ahensana/water-level/RealDataFromSite/WhatsApp Image 2026-08-13 at 1.24.08 PM.jpeg

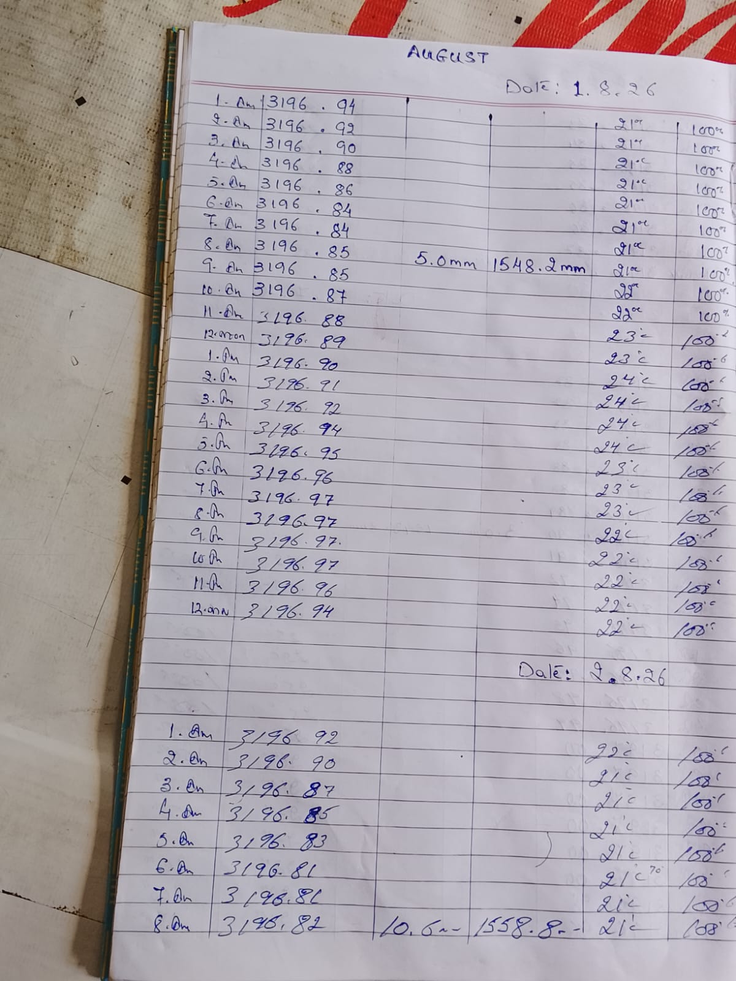
RealDataFromSite/WhatsApp Image 2026-08-13 at 1.24.08 PM.jpeg
