ahensana/water-level/RealDataFromSite/WhatsApp Image 2026-08-13 at 1.24.14 PM.jpeg

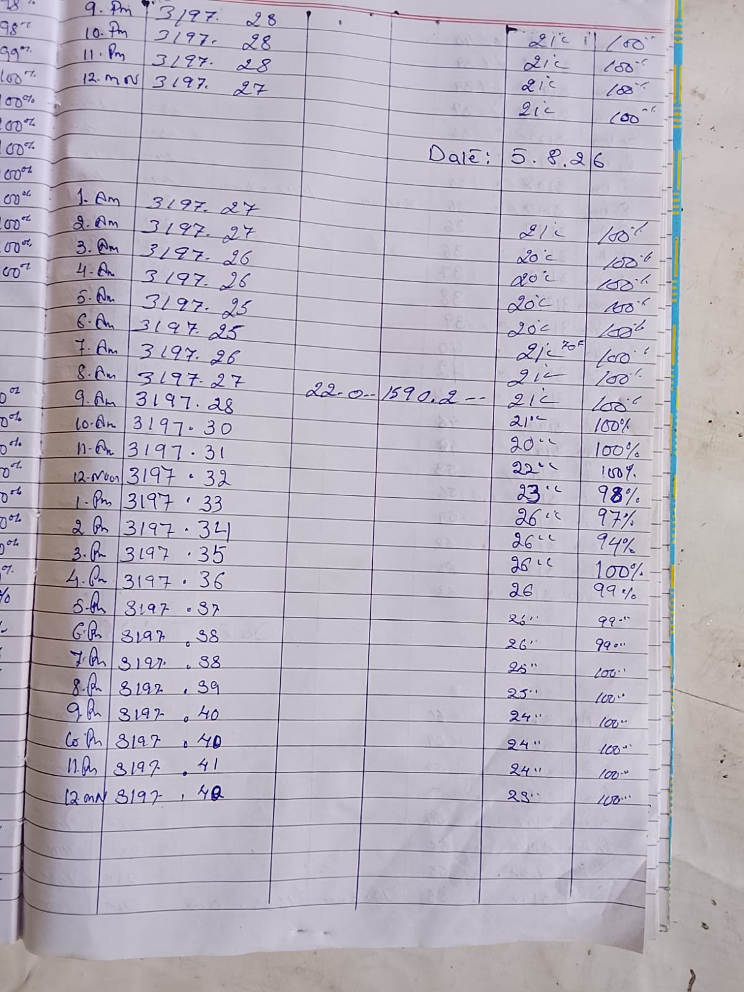
RealDataFromSite/WhatsApp Image 2026-08-13 at 1.24.14 PM.jpeg
