ahensana/water-level/(commit log)

2026-08-05 Add initial implementation for ESP32-S3 water level monitoring with EC200U modem
    - Introduced `esp32s3_ec200u_test.ino` for water level bring-up test, including modem and sensor setup, self-test procedures, and data upload to Firebase.
    - Created `.firebase/hosting.YXBwXGRpc3Q.cache` for hosting assets.
    - Added `package-lock.json` for project dependencies management.
2026-09-25 Show the last trusted reading instead of a loading shimmer
    Three related fixes to how the dashboard behaves once readings stop being
    trusted:
    - HeroStats/GaugeCard treated "too old to trust" the same as "still
    loading", so the cards went blank after an hour even though the last
    trusted reading was in hand. They now show it, badged Not current, with
    no zone colour so it cannot read as a live safe/critical state.
    - "Last Updated" showed the last TRUSTED reading, so a device uploading
    rejected readings looked like a device that had gone silent. It now
    shows the last reading received, with the trusted time beside it.
    - The live-median fallback had no age limit, so with 98% of readin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
2026-09-25 Re-calibrate: the sensor moved between 1 and 11 Sep 2026
    The gauge held at ~3201.3 ft while the air gap fell from 3265 mm (1 Sep)
    to ~888 mm (11 Sep), so every reading since read ~7.4 ft high: the
    dashboard showed 3209 ft against a register reading 3202.
    - sensorElevationFt 3212.16 -> 3204.73, fitted on 16 Sep, the only day
    since the move with a full steady feed (2212 readings, 1114-1115 mm,
    18 logged hours, implied elevation spread 0.15 ft).
    - dataStartMs 5 Aug -> 11 Sep. The Aug record is good data on the old
    datum; shown with the new constant it would invent a 7.4 ft collapse.
    - September register pages and the days fitted against added to
    tools/fieldLog.mjs.
    pipelineCheck over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
2026-09-25 Export the trusted reading history as a formatted .xlsx
    A CSV filed as a departmental record arrives in Excel with every column
    at the 8.43-character default and every measurement as text, so long
    timestamps show as #### and nothing can be sorted or totalled.
    The workbook carries units in the header, keeps measurements numeric
    with display formats, freezes and filters the header row, and sizes each
    column to its widest value. Provenance sits above the table: period, row
    count, filters applied and the calibration constant, so two exports
    taken either side of a re-fit are not mistaken for each other.
    ExcelJS is dynamically imported (929 kB, its own chunk) so only sessions
    that export pay for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
2026-09-28 Re-calibrate to 3209.04 and fix the resync latch
    The mount moved again. The register rose 3202.27 -> 3202.51 across 27-28
    Sep while the sensor's air gap moved 4.3 ft, so the gauge was reading
    3198.2 ft against a register of 3202.5 - low, and in the Safe band while
    the real level was in Warning.
    - sensorElevationFt 3204.73 -> 3209.04, fitted on 84 readings holding
    1973-1991 mm between 14:00 and 14:38 IST against the noon register
    entry. Third datum in seven weeks; the note in config.ts now says
    plainly that this is a running correction, not a calibration.
    - dataStartMs -> 28 Sep, the current mount position.
    - isSustainedStep measured the spread of the whole pending buffer, which
    is n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
2026-09-28 Keep every month displayable with dated calibration epochs
    The mount has moved twice, and a single constant meant cutting the
    record forward on every re-fit: dataStartMs went 5 Aug -> 11 Sep -> 28
    Sep, so asking for August showed nothing and the browser held 90 minutes
    of readings.
    Each period now carries the elevation that was true when its readings
    were taken (CALIBRATION_EPOCHS), and distanceToWaterLevelFt takes the
    reading's timestamp. dataStartMs goes back to 5 Aug, the whole
    commissioned record; only pre-mount bench testing stays excluded.
    pipelineCheck over both months: 194 scored checkpoints (was 32), median
    error -0.011 ft, 157/194 within 0.1 ft. August is back to its own fit
    (per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
2026-09-28 Lift the 31-day cap on period loads
    The history browser and the interval report both refused any range over
    31 days, so a record that now spans August onward could not be read from
    the views built to read it.
    Ranges are clamped to the record (dataStartMs .. now) instead of being
    rejected, since the push-key query makes a long period a question of
    bandwidth, not correctness. Added Last 90 days and All data presets, and
    a long load says how many days it is fetching rather than appearing to
    hang.
2026-09-28 Show every filtered row, and add Clear to the period picker
    The table paged 300 rows behind a Show more button, so reading a long
    period meant clicking through it. It now renders the whole filtered set:
    the scrollbar spans every row, and only the rows near the viewport are
    mounted, since a month at 30-second cadence is ~89,000 rows and eleven
    cells each is enough DOM to freeze the tab.
    Row height is measured from the first rendered row rather than assumed.
    The spacers are sized in pixels, so an assumed height that is off by a
    pixel compounds until the scrollbar and the rows disagree and the last
    readings cannot be reached.
    Clear drops the loaded period and returns to the session's own hist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
2026-10-07 Require server timestamps on every reading
    Readings must now carry the database's own clock ({".sv":"timestamp"}), so
    nobody can insert backdated or future-dated readings. Both firmwares already
    send a server timestamp, so the site device keeps posting unchanged.
    Also adds a public-read, no-write /satellite node for the new satellite and
    weather cards.
    Claude-Session: https://claude.ai/code/session_01TRUdAXhAQPm3saSdp6rRfg
2026-10-07 Add satellite and weather data, and a device ingest endpoint
    Cloud Functions (Python, asia-south1):
    - ingest: the device posts here with a key from secrets.h; the function
    validates and writes with the Admin SDK, so the database can later refuse
    all public writes (database.rules.locked.json, deploy after reflashing).
    - refresh_weather: Google Weather API at the reservoir, past 24 h and next
    72 h of rain, hourly.
    - refresh_rainfall: JAXA GSMaP satellite rainfall averaged over the Umiam
    catchment (traced from HydroBASINS), hourly, with its real data lag.
    - refresh_reservoir: reservoir water area from Sentinel-1 radar (through
    cloud) and Sentinel-2 when clear, plus the latest images,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
2026-10-22 final calibration
